JuliusOrtstadt/Maze_Game/README.md

# Maze_Game

Projet Arduino: Maze Game

Bienvenue sur le GitHub de mon projet arduino Maze_Game!
