JuliusOrtstadt/Maze_Game/Pièces/README.md

# Pièces

Contient toutes les pièces imprimées en 3D et découpé à la découpeuse laser
