JuliusOrtstadt/Maze_Game/Documentation/Presentation/README.md

# Présentation du projet

Contient:
- Le rapport final.
- La vidéo de présentation.
- La présentation PowerPoint en pdf.
