JuliusOrtstadt/Maze_Game/Documentation/Rapports/Rapport_Séance_8-Julius_ORTSTADT.md

# Rapport Séance 8 - 02.03.2023

## Avant la séance d’aujourd’hui, j‘ai : 
-	Créé une version préliminaire de test du code final. Ce dernier test une majeure partie des fonctionnalités notamment le contrôle des servo-moteurs avec le joystick, la navigation à travers le menu et l’affichage des différentes étapes à travers l’écran LCD et les deux LED.
-	Peint le labyrinthe en noir.\
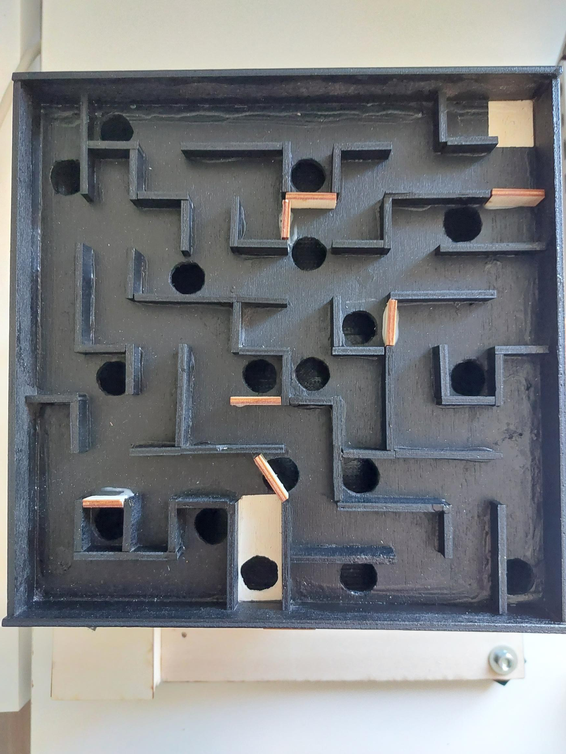
[picture p1: Documentation/Pictures/Seance_8/Labyrinth.jpg]
Labyrinthe


-	Modélisé les dernières pièces sur OnShape.\
  Le système de détection de la bille\
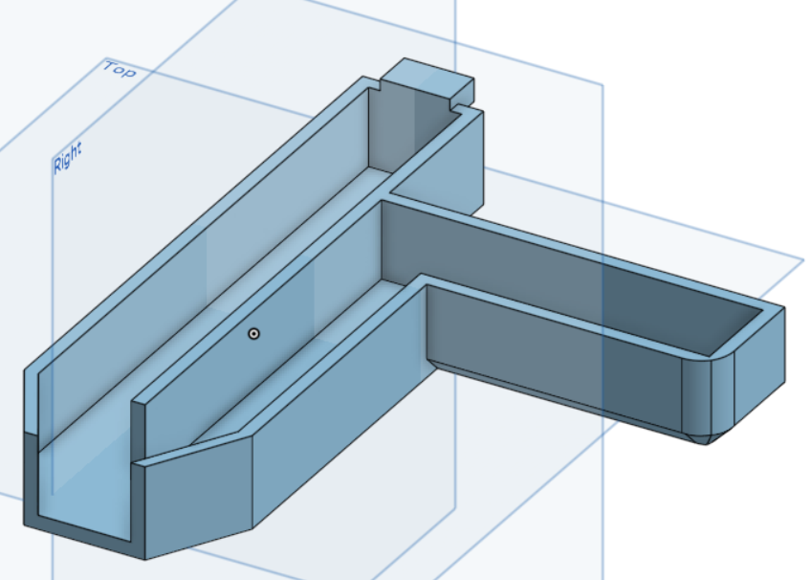
[picture p2: Documentation/Pictures/Seance_8/Collection.png]
Pièce 1
\
  La fixation pour le servo de la porte\
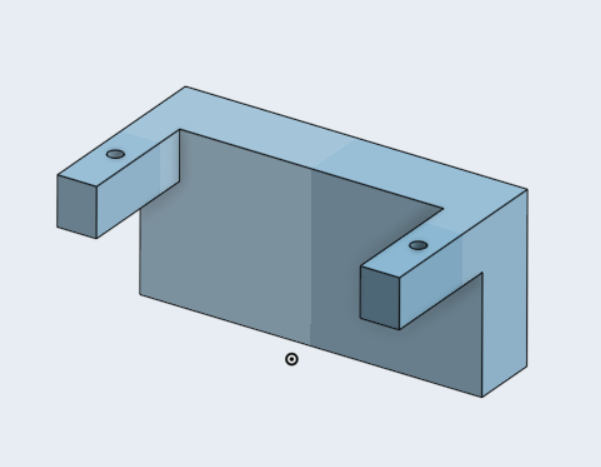
[picture p3: Documentation/Pictures/Seance_8/Fixation_Servo_Door.png]
Pièce 2
\
  La fixation pour la porte\
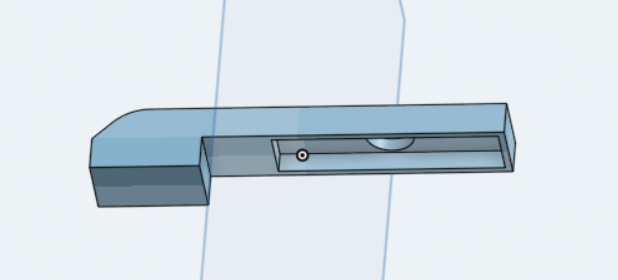
[picture p4: Documentation/Pictures/Seance_8/Door_Part.png]
Pièce 3


-	Commencé la soudure des composants.
-	Fixé certains composants notamment la carte Arduino et les planches à essai.\
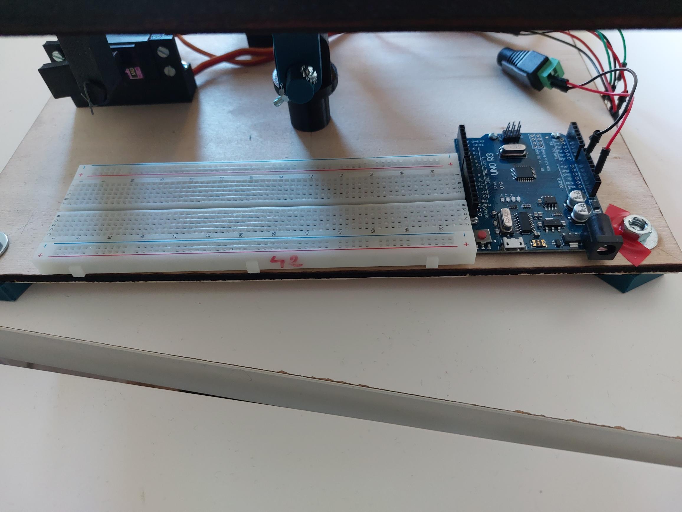
[picture p5: Documentation/Pictures/Seance_8/Fixation.jpg]
Fixage


## Lors de cette séance, j’ai :
-	Réglé un problème lié à l’alimentation.
-	Continuer le développement du code. Il ne manque que quelques réglages et de faire le calibrage des servo-moteurs et du joystick.\
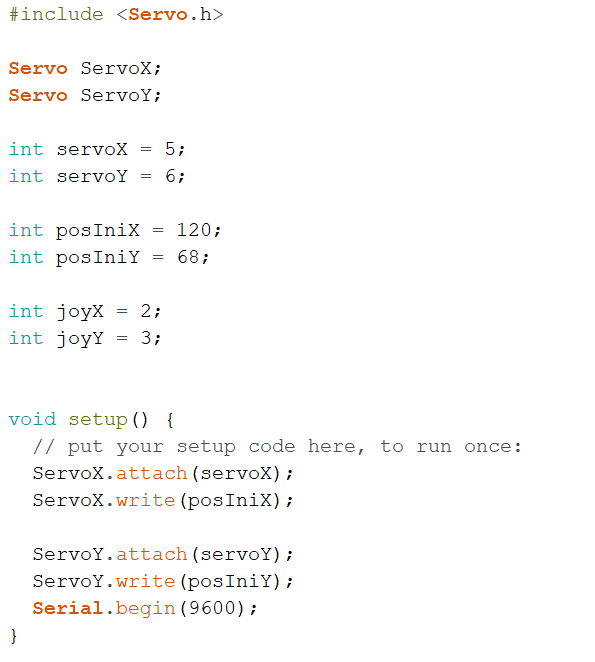
[picture p6: Documentation/Pictures/Seance_8/Code_p1.png]
Code 1

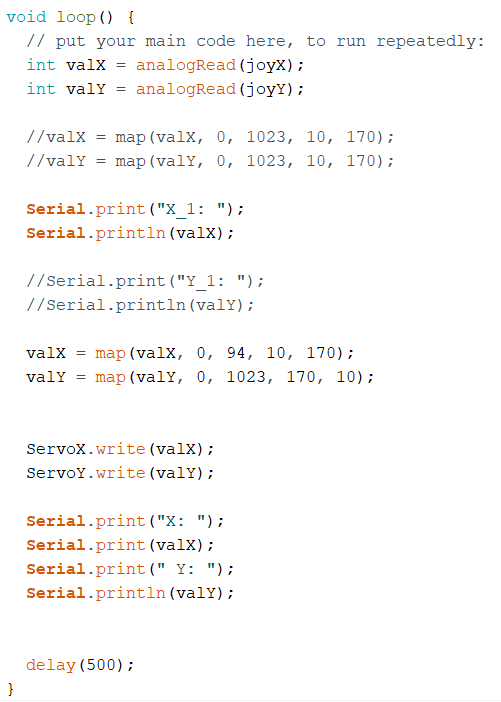
[picture p7: Documentation/Pictures/Seance_8/Code_p2.png]
Code 2


-	Imprimer les dernières pièces du projet et commencer leur intégration dans le projet.
-	Continué les soudures notamment des LED et du bouton.\
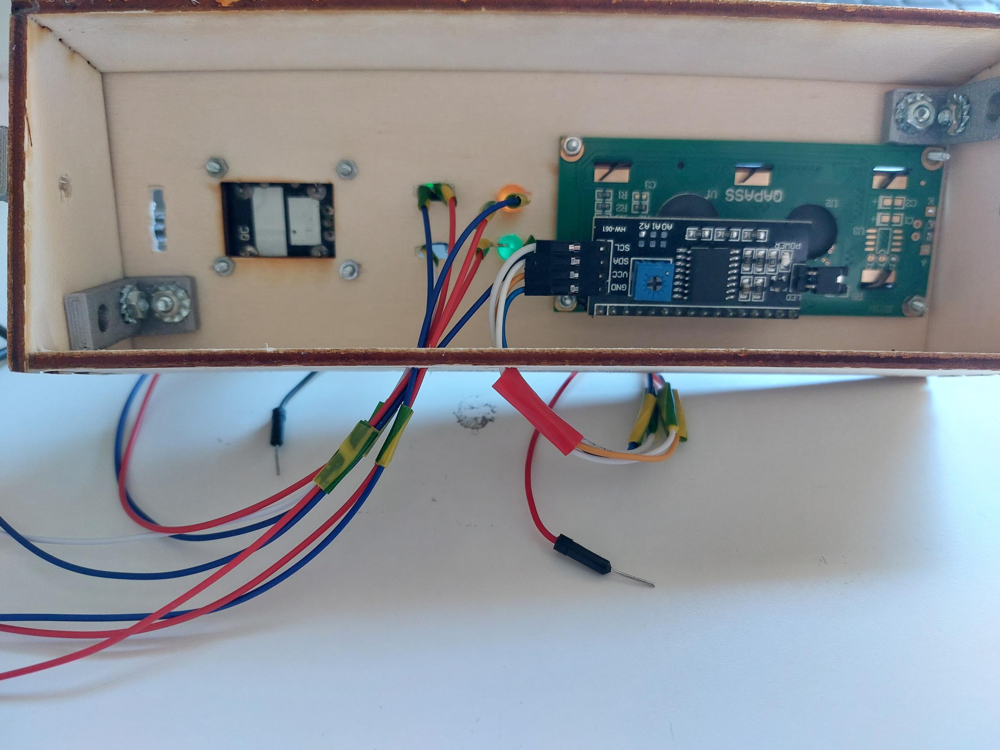
[picture p8: Documentation/Pictures/Seance_8/Welds.jpg]
Soudures

-	Presque fini l’assemblage complet. Il ne manque que le système de libération qui est prêt à être assemblé.\
  Fixation du servo pour la porte\
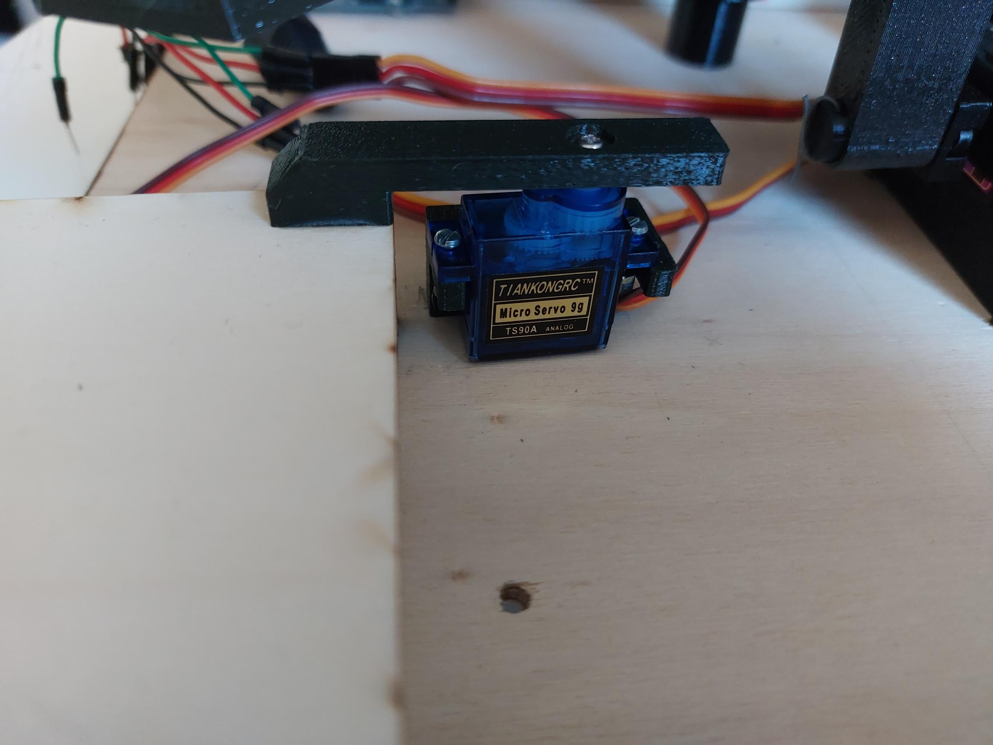
[picture p9: Documentation/Pictures/Seance_8/Servo_Door.jpg]
Servo Porte
