JuliusOrtstadt/Maze_Game/Documentation/Rapports/Rapport_Séance_7-Julius_ORTSTADT.md

# Rapport séance 7 - 16.02.2023

Avant cette séance, j’ai :
-	Fini l’assemblage du labyrinthe 
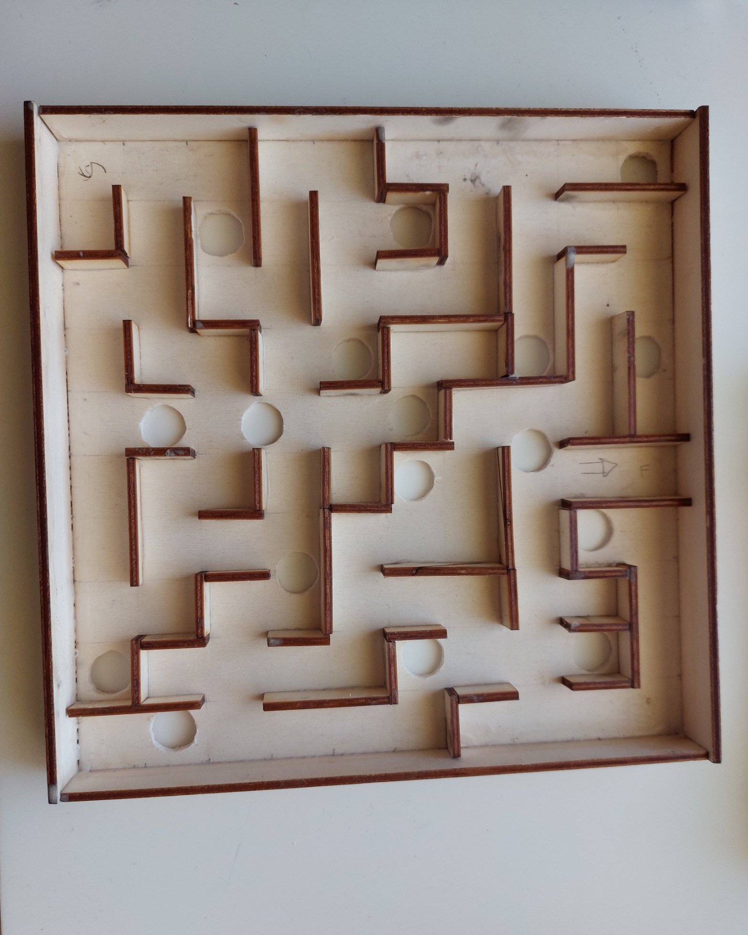
[picture p10: Documentation/Pictures/Seance_7/Labyrinth.jpg]
Assemblage labyrinthe fini

-	Commencer l’assemblage du bloc de contrôle

-	Commencé le code principal

Lors de cette séance, j‘ai :
-	Fini l’assemblage du bloc de contrôle 
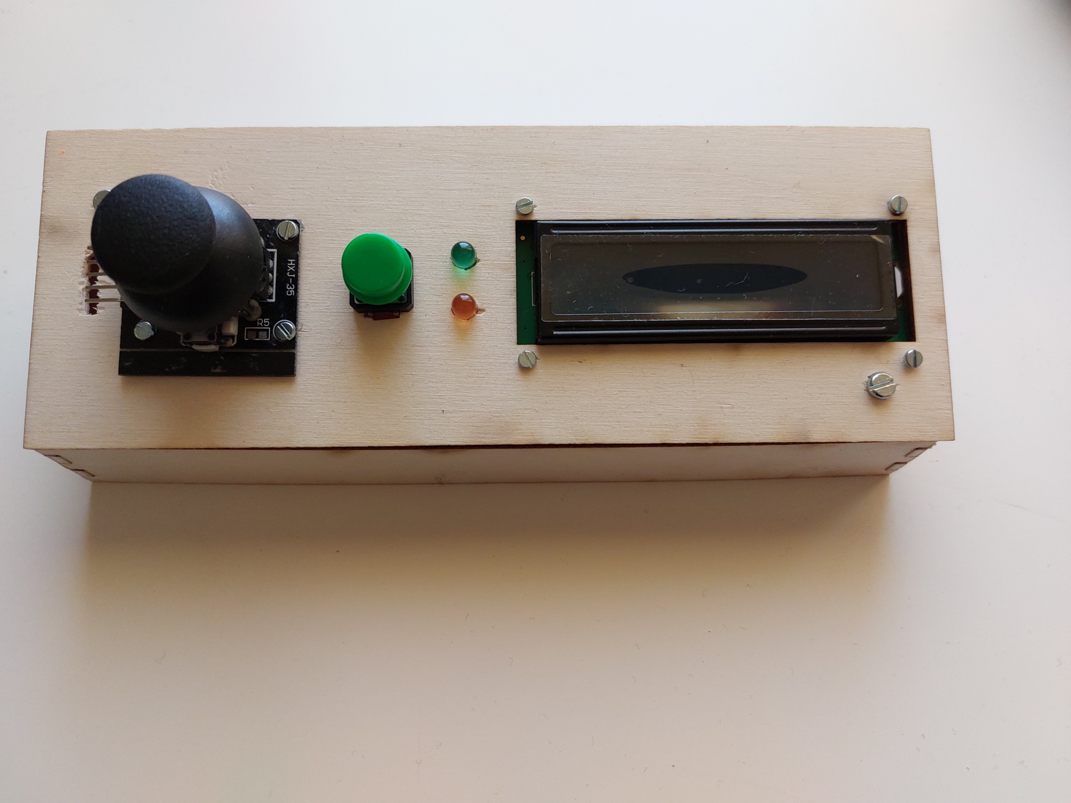
[picture p11: Documentation/Pictures/Seance_7/Menu_Block.jpg]
Bloc de contrôle


-	Fait l’assemblage du mécanisme pour le mouvement de plaque
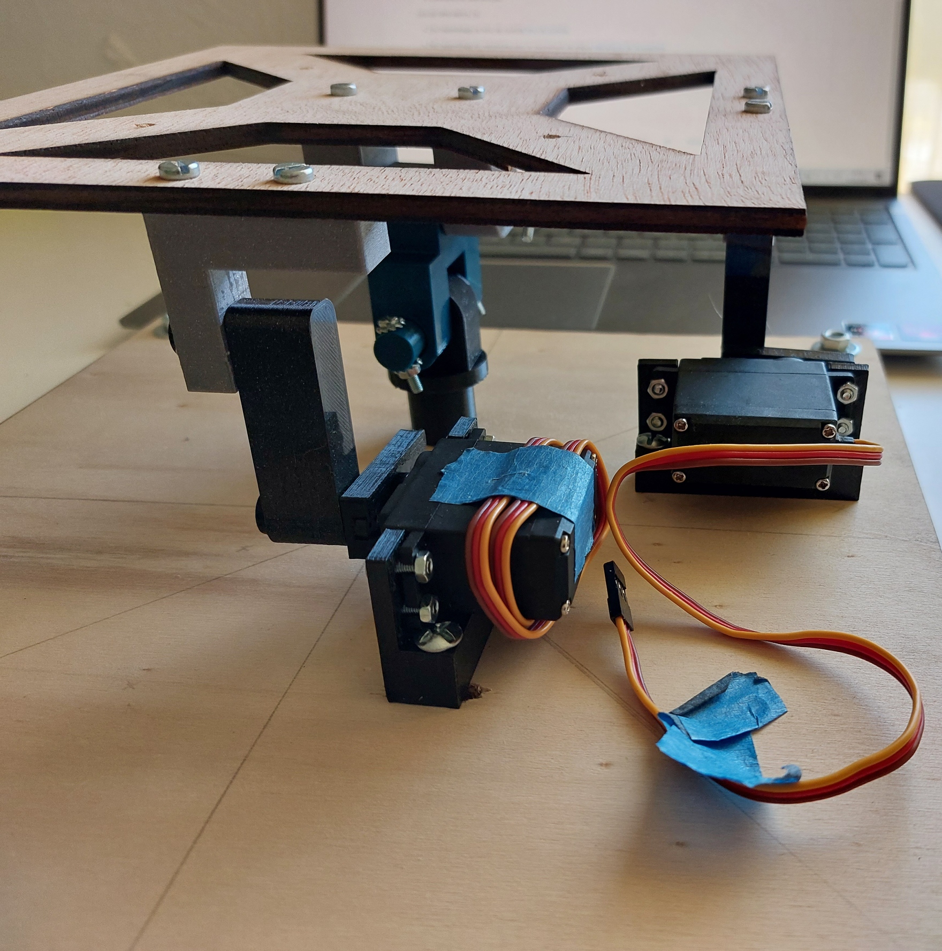
[picture p12: Documentation/Pictures/Seance_7/Mouvement_Control.jpg]
Mécanisme de mouvement


-	Modélisé et lancé l’impression des pièces permettant la recollection de la bille
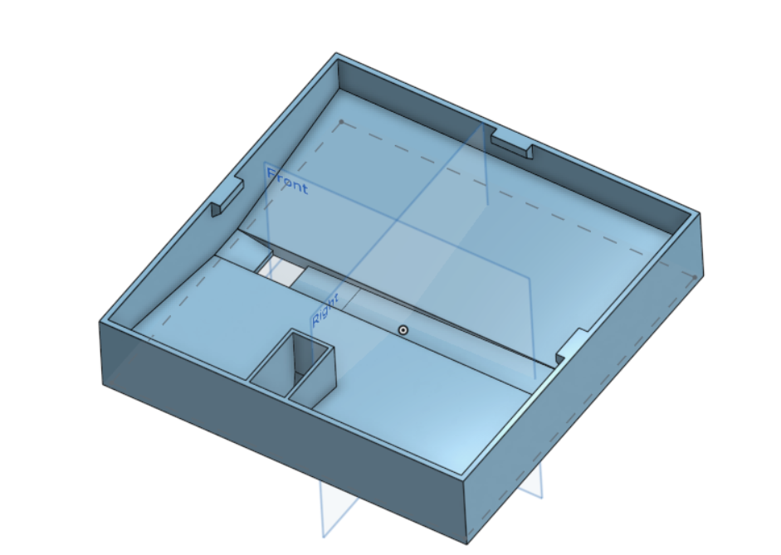
[picture p13: Documentation/Pictures/Seance_7/Collection_System.PNG]
Impression des pièces pour la recollection
