JuliusOrtstadt/Maze_Game/Documentation/Rapports/Rapport_Séance_6-Julius_ORTSTADT.md

# Rapport séance 6 - 09.02.2023

**Travail avant la séance :**\
Avant cette séance j’ai notamment préparé certaines pièces pour impression qui vont assurer le mouvement du plateau de jeu ainsi que permettre au joueur de contrôler ce mouvement.

-	Modélisation de pièces pour les servos moteurs afin d’assurer la transmission du mouvement au plateau de jeu.\
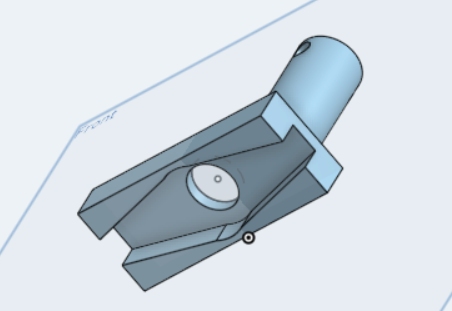
[picture p14: Documentation/Pictures/Seance_6/Servo_Adapter.PNG]
Pièces servos


-	Modélisation du bloc « menu » où une grande partie des composants sera installée.

**Travail lors de la séance :**\
Lors de cette séance, j’ai commencé l’assemblage du projet et j’ai aussi fait quelques changements sur des pièces dont tout ne fonctionner pas exactement comme prévu.

-	Fixation des supports sur la planche de contrôle avec des vis.\
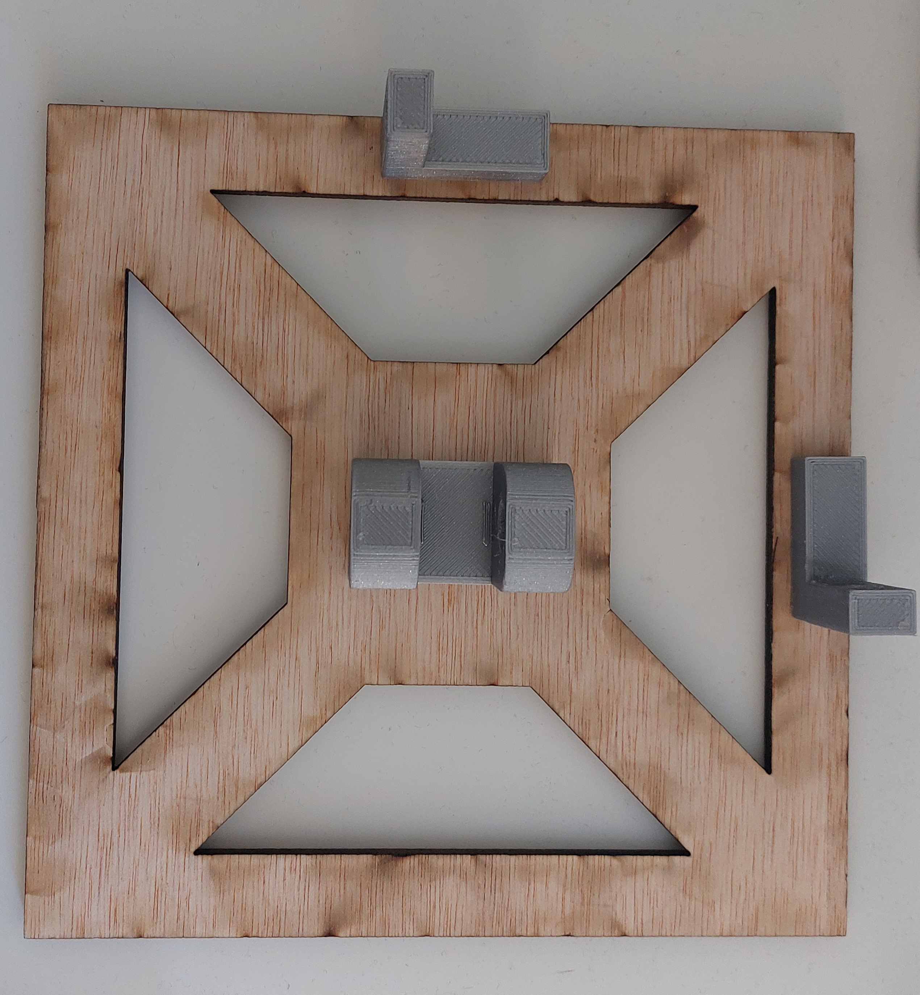
[picture p15: Documentation/Pictures/Seance_6/Support_Assembly.jpg]
Fixation des supports


-	Perçage des trous du labyrinthe et début du collage des pièces du labyrinthe.\
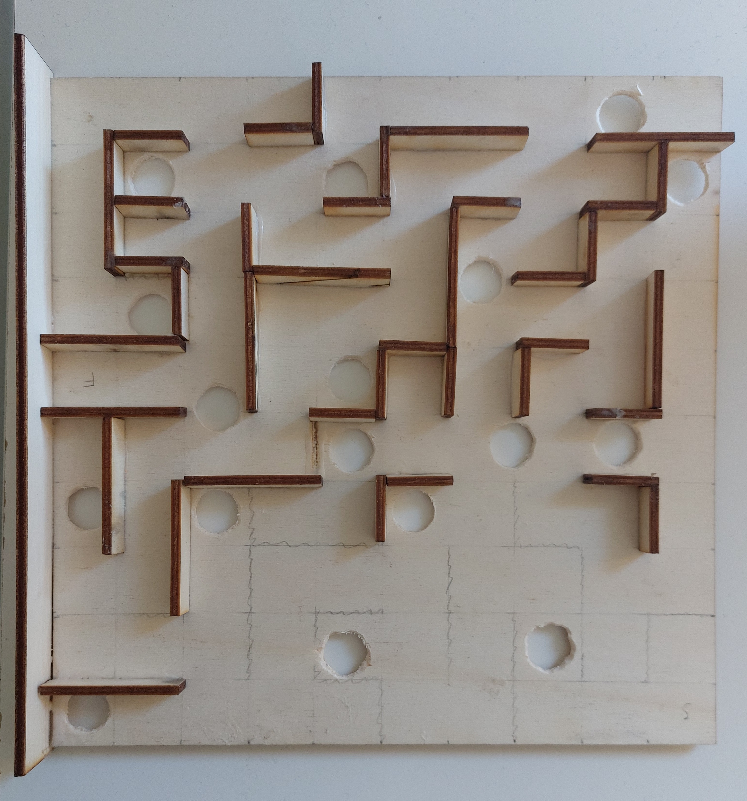
[picture p16: Documentation/Pictures/Seance_6/Labyrinth_Assembly.jpg]
Début de l'assemblage du labyrinthe


-	Amélioration du bloc "menu" afin que l’assemblage soit plus facile.\
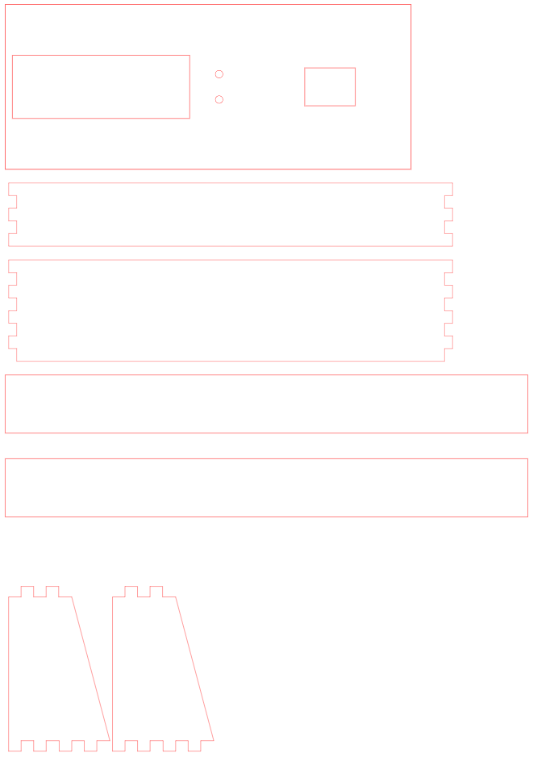
[picture p17: Documentation/Pictures/Seance_6/Menu_Block_Pieces.PNG]
Modification du bloc "menu"
