JuliusOrtstadt/Maze_Game/Documentation/Rapports/Rapport_Séance_5-Julius_ORTSTADT.md

# Rapport Séance 5 - 02.02.2023

Avant cette séance, j’ai dessiné les pièces du labyrinthe pour la découpe laser. 
J’ai ensuite découpé ces pièces et commencer l’assemblage.
- Murs pour le labyrinthe\
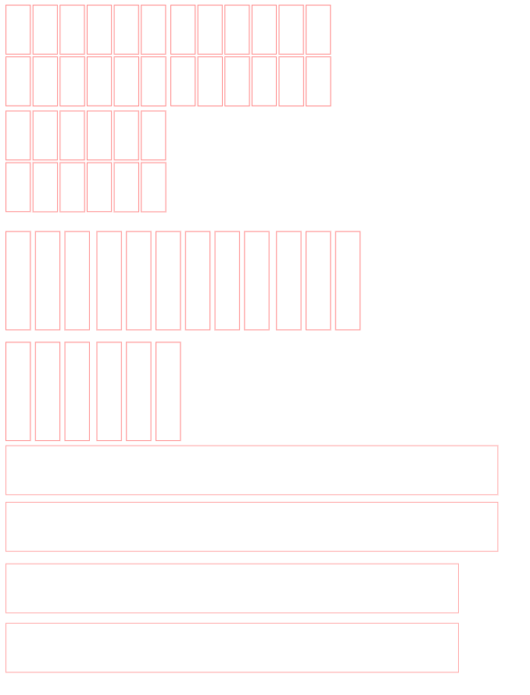
[picture p18: Documentation/Pictures/Seance_5/Labyrinth_Wall.PNG]
Murs pour le labyrinthe


- Plaque de base pour le labyrinthe\
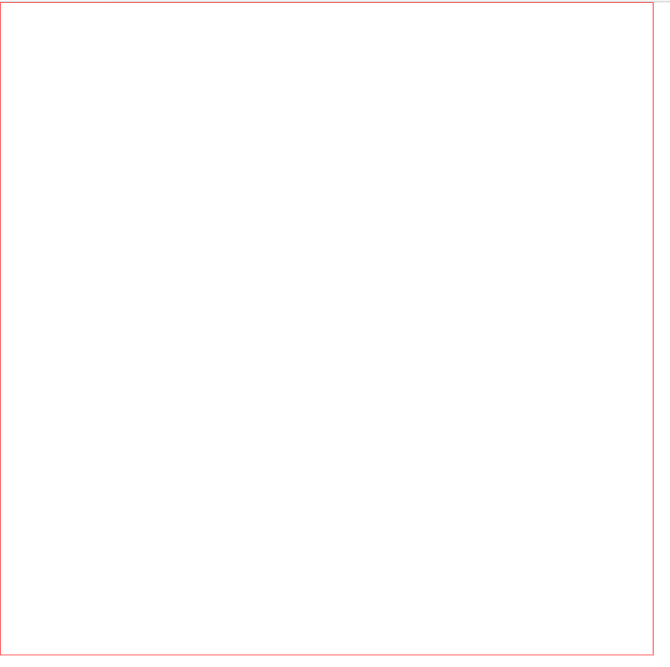
[picture p19: Documentation/Pictures/Seance_5/Labyrinth_Plate.PNG]
Plaque de base du labyrithne


- Plaque qui sera bougée par les servos moteurs\
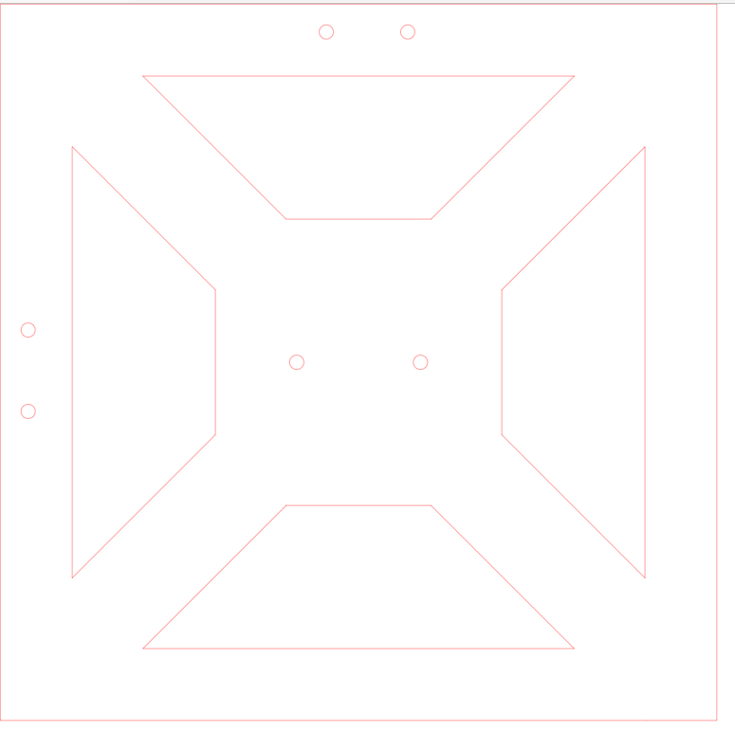
[picture p20: Documentation/Pictures/Seance_5/Main_Plate.PNG]
Plaque de base


Ensuite, lors de cette séance, j’ai commencé à coder les fonctionnalités du joystick.
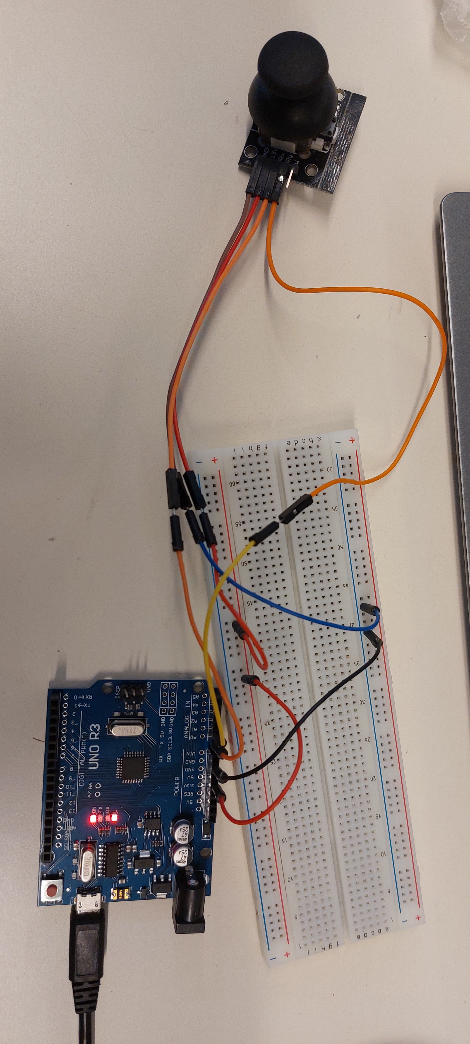
[picture p21: Documentation/Pictures/Seance_5/Montage_joystick.jpg]
Image du montage


De plus, j’ai réussi à régler le problème de l’écran LCD.\ 
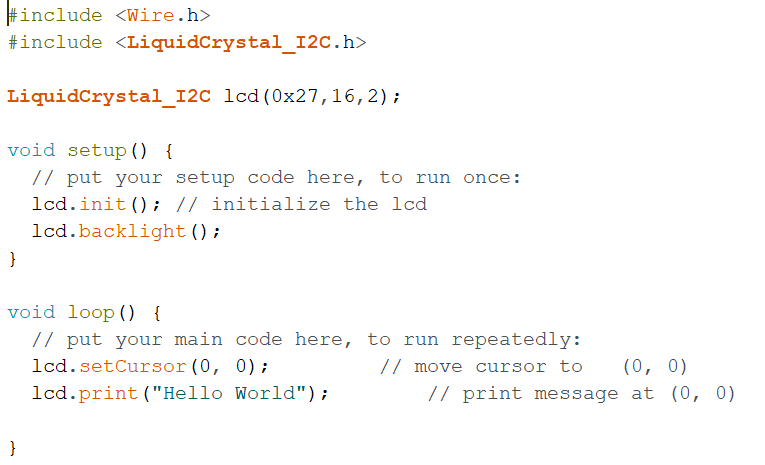
[picture p22: Documentation/Pictures/Seance_5/Code_LCD_Test.PNG]
Code écran LCD


J’ai aussi tester un autre système de détection de la bille avec les capteurs que l’on avait utiliser pour les voitures suiveurs de ligne. Ce système permettrait de plus compacter la construction et de simplifier l’assemblage.\
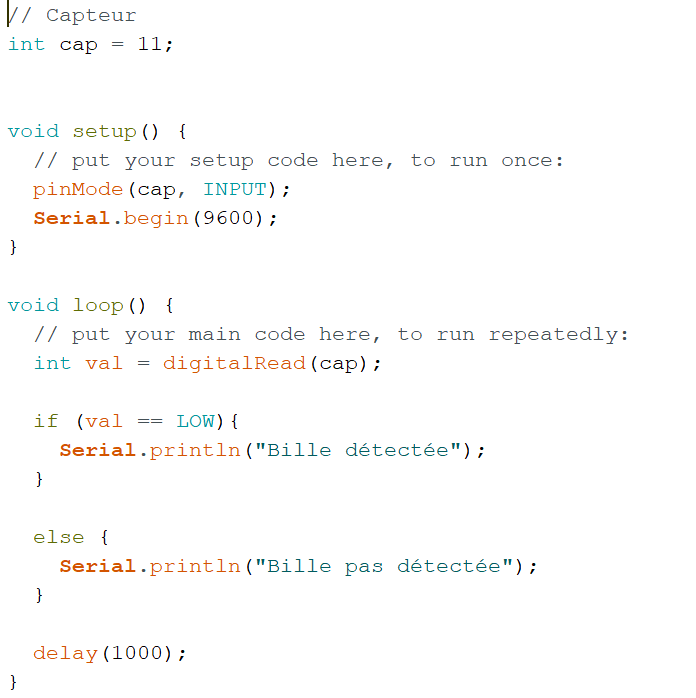
[picture p23: Documentation/Pictures/Seance_5/Code_Detection_Test.PNG]
Code système de détection
