JuliusOrtstadt/Maze_Game/Documentation/Rapports/Rapport_Séance_4-Julius_ORTSTADT.md

# Rapport de la séance 4 - 16.01.2023

Lors de cette séance j‘ai avancer les montages électroniques. 
-	J'ai fait des test avec l’écran LCD avec I2C. Cependant certains problèmes sont survenus notamment que le réglage du contraste était impossible ce qui ne permettait pas d'apercevoir le texte.\
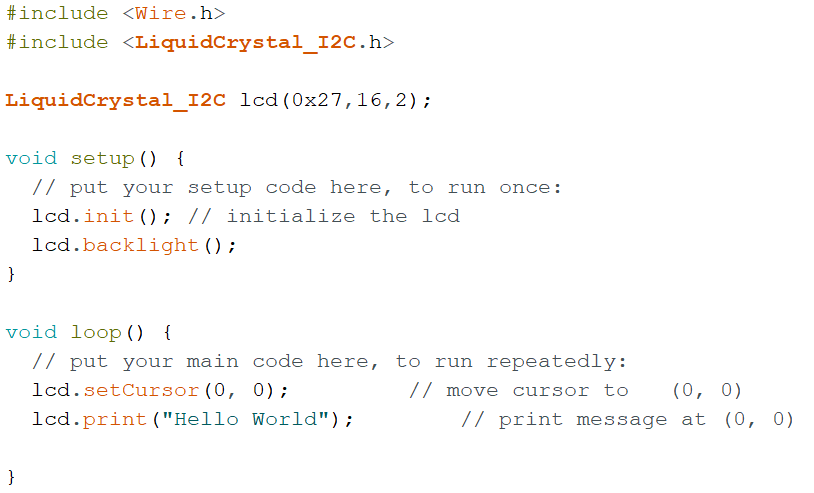
[picture p24: Documentation/Pictures/Seance_4/Code_LCD.PNG]
Code de test


J’ai revu certaines versions des pièces. Par exemple la fixation du servo n’était pas assez large.\
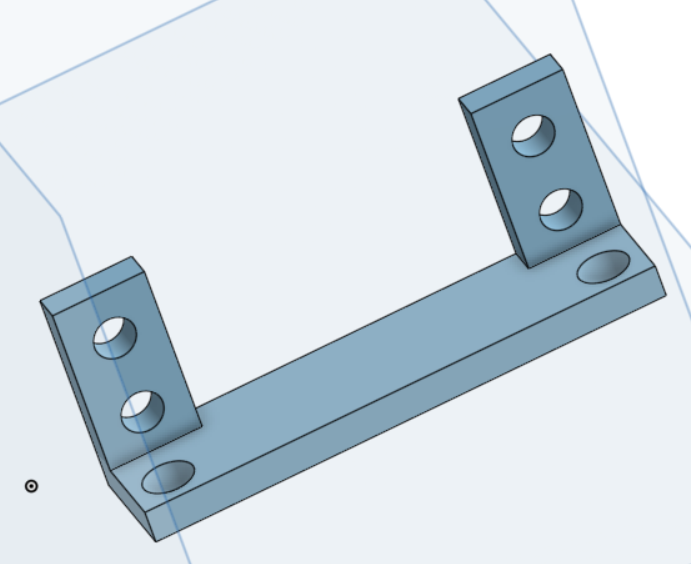
[picture p25: Documentation/Pictures/Seance_4/Fixation_Servo.PNG]
Fixation servo


Et pour la plaque sur laquelle sera fixé le labyrinthe, j’ai décomposé l’assemblage en plusieurs parties, notamment, les angles ainsi que la fixation pour le joint vont être fait séparément par impression 3D puis fixé sur la planche avec des vis. Ces pièces ont été lancé en impression 3D. La planche elle-même sera faites en bois par découpe laser.\
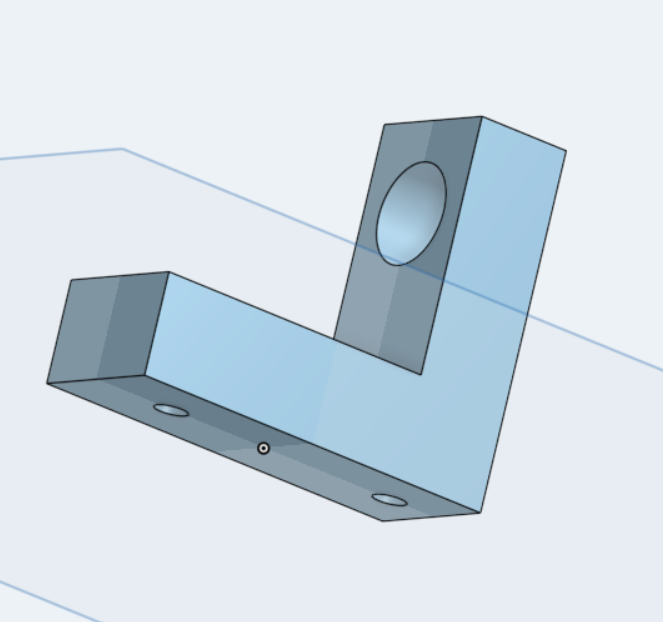
[picture p26: Documentation/Pictures/Seance_4/Angle.PNG]
Angles


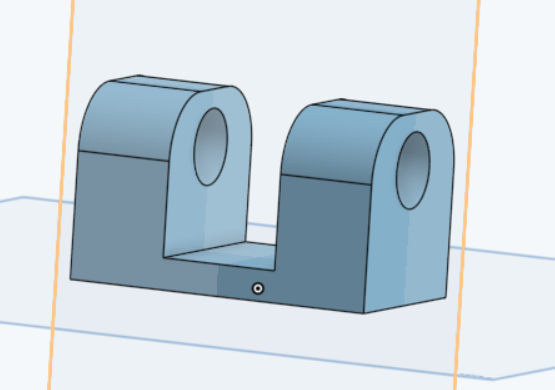
[picture p27: Documentation/Pictures/Seance_4/Fixation_Game_Plate.PNG]
Fixation joint


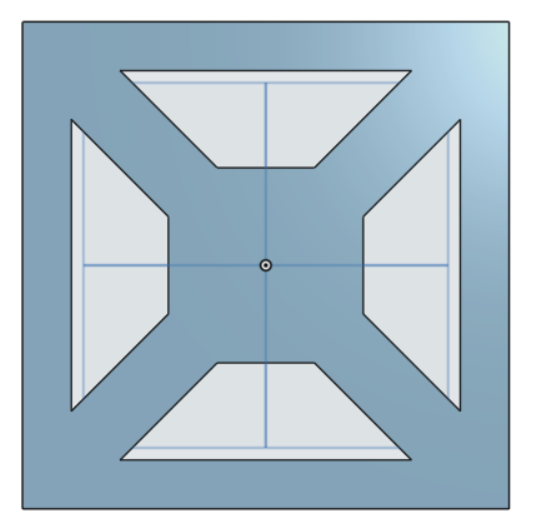
[picture p28: Documentation/Pictures/Seance_4/Main_Plate_2.PNG]
Planche principale


J’ai aussi commencer à modéliser le « bloc de contrôle » donc le bloc sur lequel seront fixé tout les boutons, l’écran, le joystick et les LED.
Finalement, j'ai aussi présenter l'avancement de mon projet lors de la présentation de mi-parcours.
