JuliusOrtstadt/Maze_Game/Documentation/Rapports/Rapport_Séance_3-Julius_ORTSTADT.md

# Rapport Séance 3 - 09.01.2023

Avant cette séance, j'ai revu certaines pièces modélisées la dernière fois et j'ai fait l'assemblage sur OnShape pour voir le rendu de la structure principale.
- Modification des certaines pièces de l'assemblage:
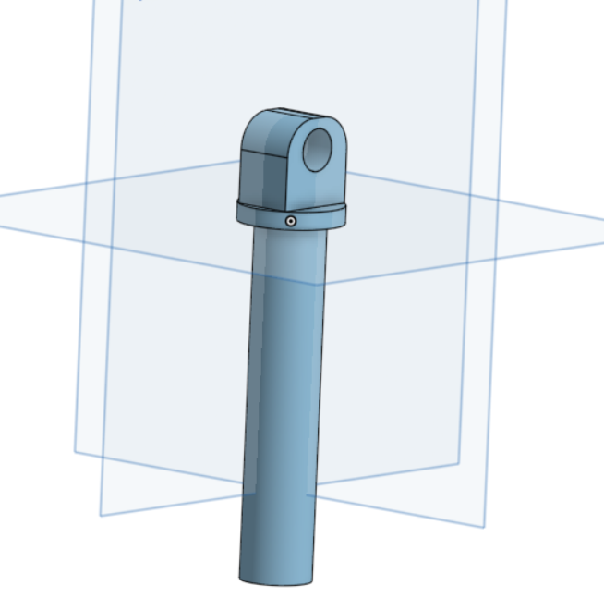
[picture p29: Documentation/Pictures/Seance_3/Main_Mouvement_Joint.PNG]

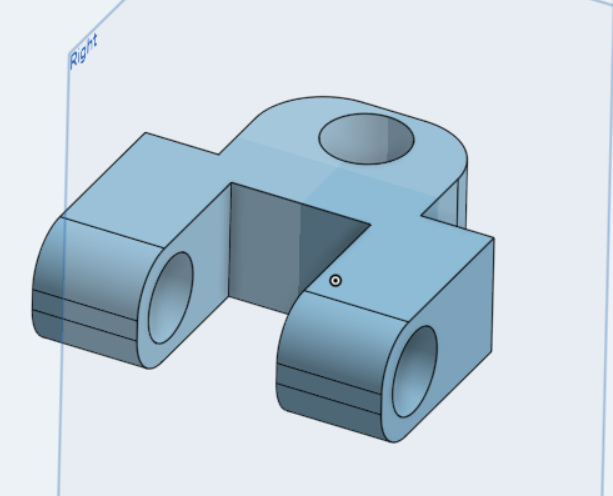
[picture p30: Documentation/Pictures/Seance_3/Main_Mouvement_Joint_2.PNG]


- Image de l'assemblage de la structure de base:
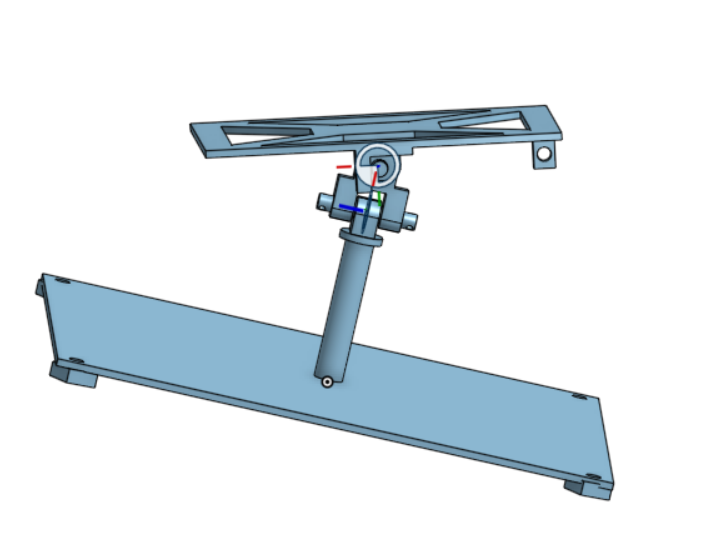
[picture p31: Documentation/Pictures/Seance_3/Assembly_1.PNG]

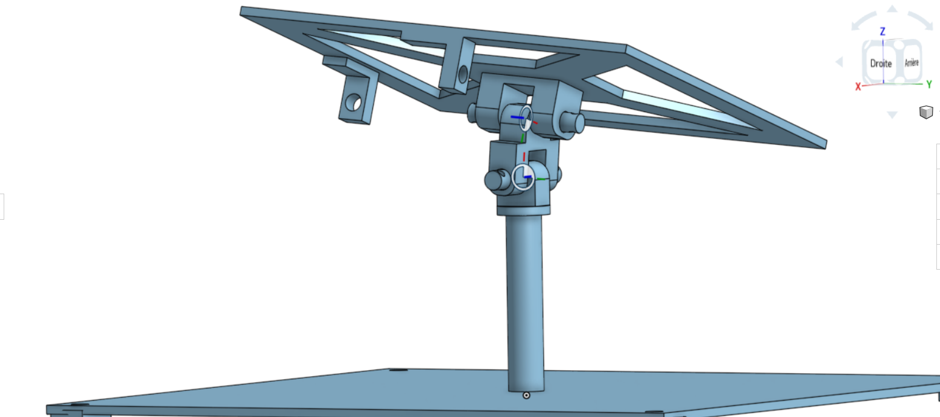
[picture p32: Documentation/Pictures/Seance_3/Assembly_2.PNG]


Lors de la séance 3, j'ai effectué différents tests de code et de montages:
- Test du servo qui active la porte qui permet par la suite de libérer la bille. 
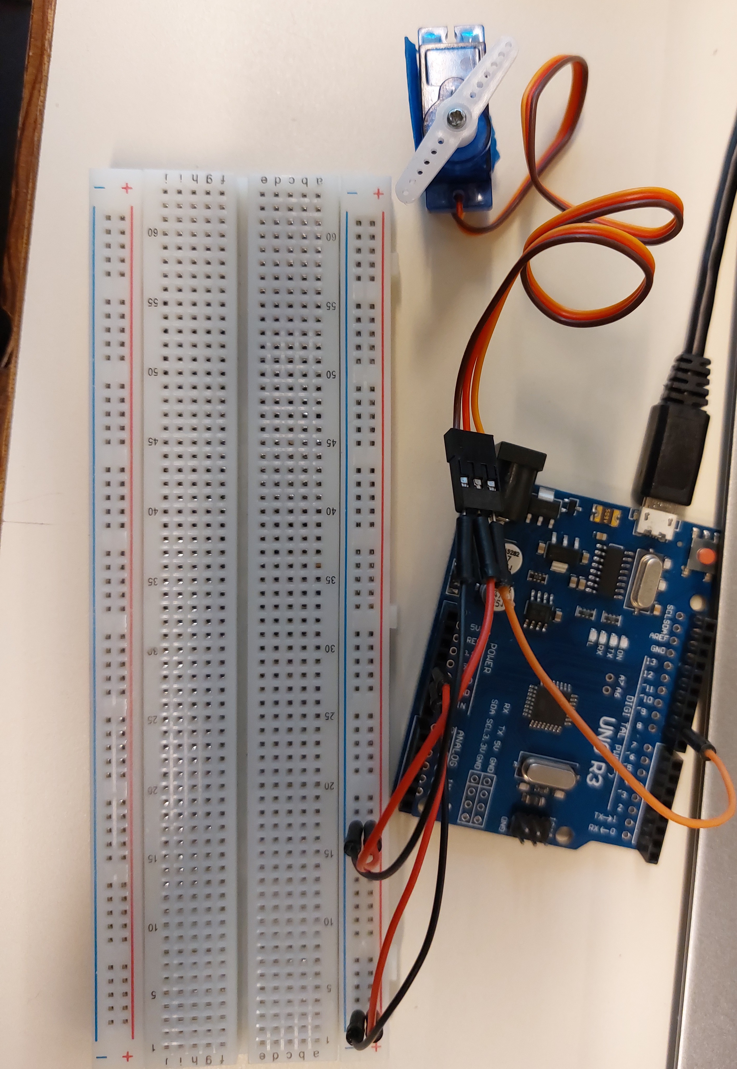
[picture p33: Documentation/Pictures/Seance_3/Montage_servo_porte.jpg]
Image du montage


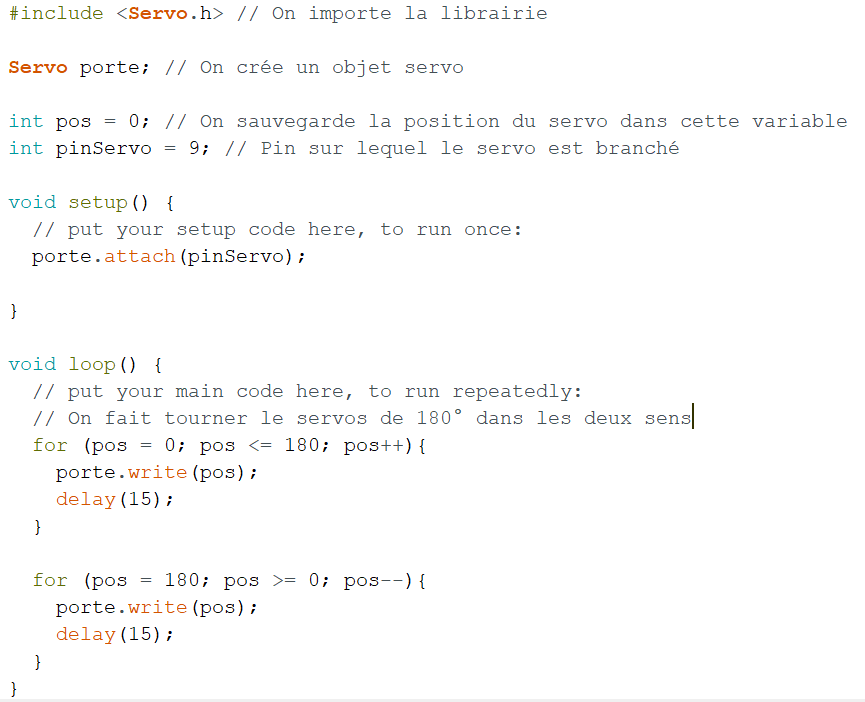
[picture p34: Documentation/Pictures/Seance_3/Code_Door_Test.PNG]
Code


- Test des boutons qui détectent si la bille est tombé et si le joueur a gagné.
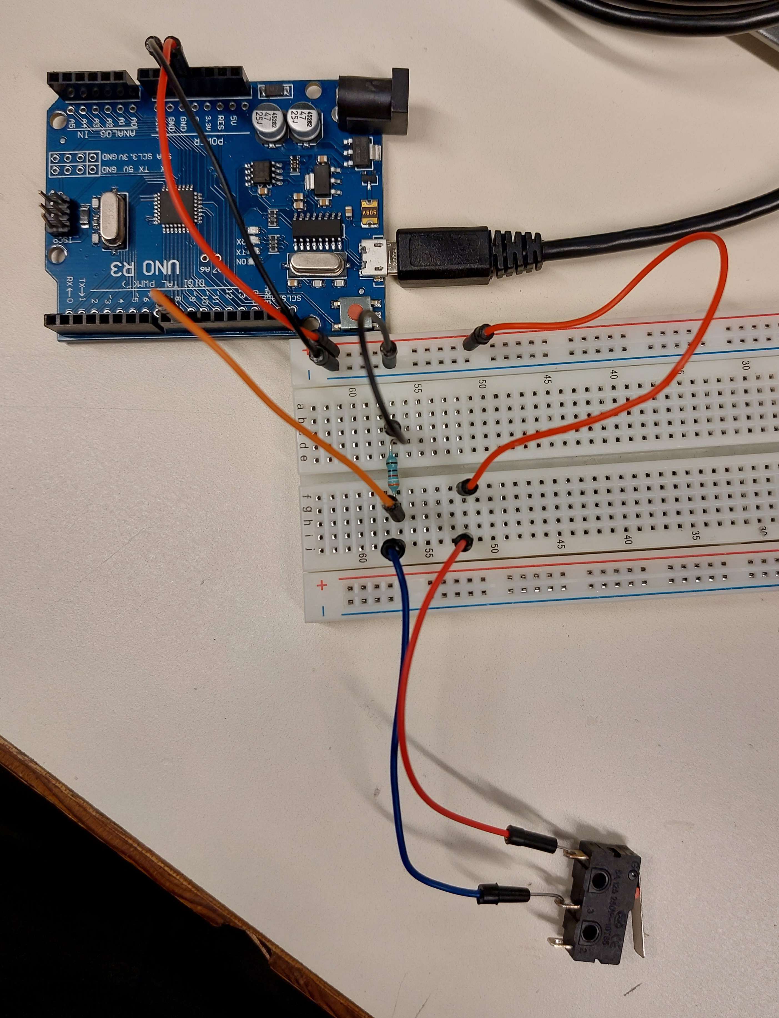
[picture p35: Documentation/Pictures/Seance_3/Montage_bouton_simple.jpg]
Image du montage


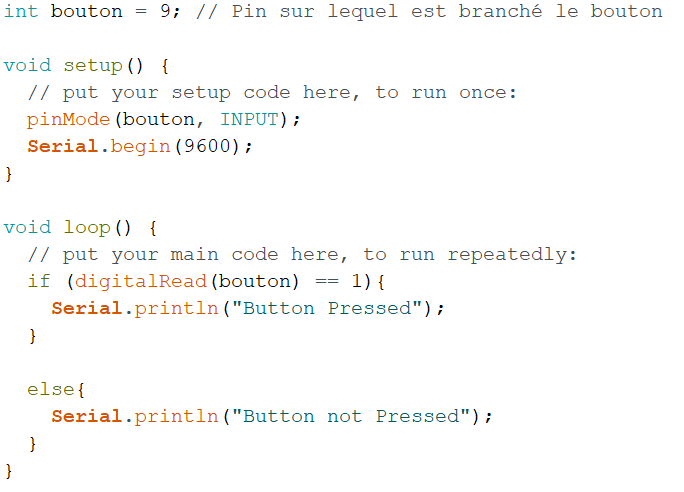
[picture p36: Documentation/Pictures/Seance_3/Code_Button_Test.PNG]
Code


De plus, la plaque principale a été découpé en 29x29cm. 
Les pièces du joints, ainsi que les barres de fixation tout comme les pieds pour la plaque principale ont été lancé en impression 3D.
