JuliusOrtstadt/Maze_Game/Documentation/Rapports/Rapport_Séance_2-Julius_ORTSTADT.md

# Rapport Séance 2 - 19.12.2022

Lors de cette séance j'ai modélisé une grande parties des pièces nécessaires pour le projet. Certaines seront imprimées en 3D tandis que d'autres comme la plaque principale sur laquelle tout sera fixé, sera faites en bois.

Les différentes pièces modélisées sont:
- La planche principale sur laquelle tout sera fixé.
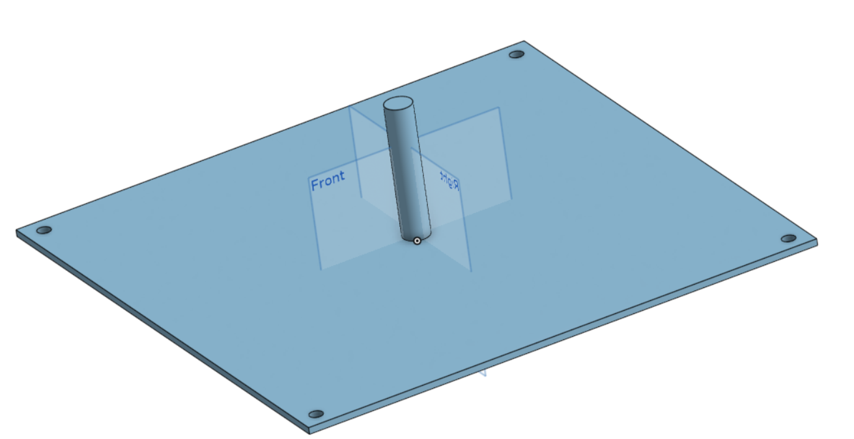
[picture p37: Documentation/Pictures/Seance_2/base_plate.PNG]
Planche principale

- Les pieds pour cette planche afin de pouvoir la poser et faire le niveau. Ce dernier sera fait avec une vis insérée dans ce pieds.

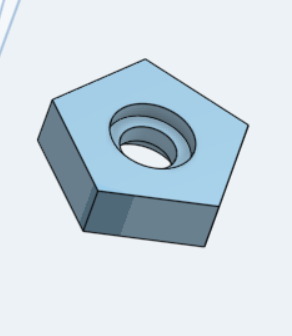
[picture p38: Documentation/Pictures/Seance_2/foot_base_plate.PNG]
Pieds de la planche principale

- Le système de maintient pour les servos moteurs qui assurent le mouvement de la planche de jeu.
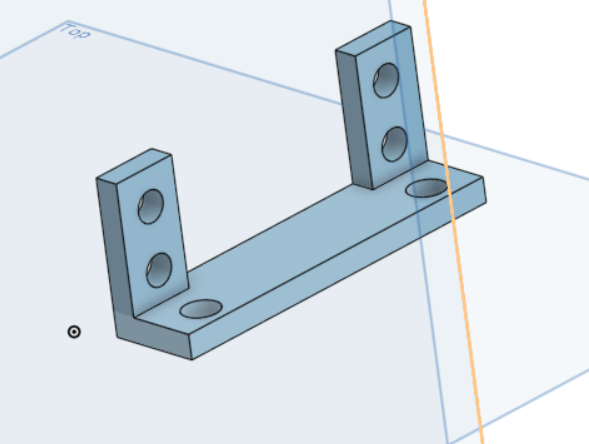
[picture p39: Documentation/Pictures/Seance_2/servo_hold.PNG]
Système de maintient pour les servos moteurs

- Les différentes parties du joint pour permettre le mouvement de la planche de jeu.
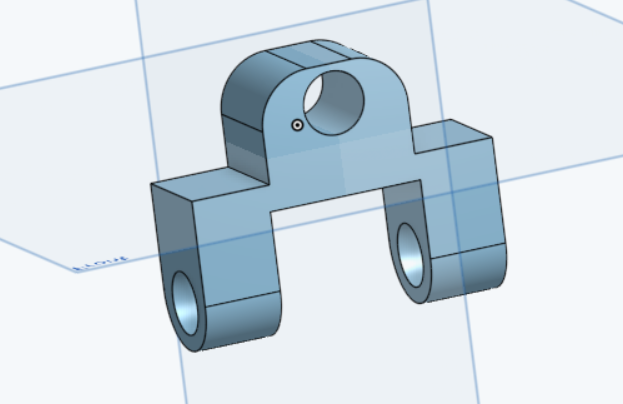
[picture p40: Documentation/Pictures/Seance_2/joint_1.PNG]
Joint partie 1

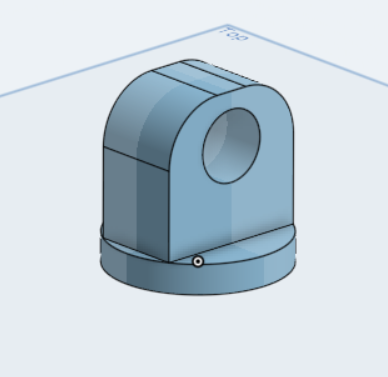
[picture p41: Documentation/Pictures/Seance_2/joint_2.PNG]
Joint partie 2

- La tige permettant d'assembler et de tenir en place les différentes parties du joint. Un fil de fer, par exemple, sera placer dans les trous au bout de la tige afin que celle-ci ne tombe pas du joint.
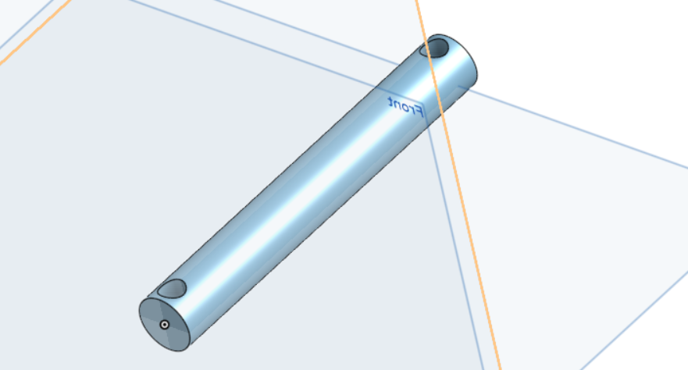
[picture p42: Documentation/Pictures/Seance_2/rod.PNG]
Tige

- La plaque sur laquelle sera fixée le labyrinthe.
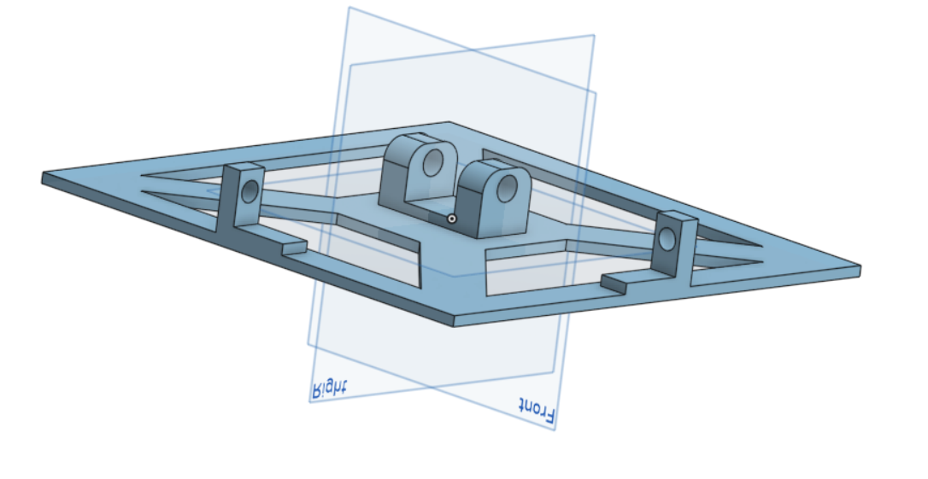
[picture p43: Documentation/Pictures/Seance_2/game_plate.PNG]
Plaque de fixation du labyrinthe


Finalement, j'ai aussi recherché des alternatives pour le système de détection de la bille, c'est-à-dire pour savoir si la bille est tombée donc si le joueur a perdu ou gagné en fonction de l'endroit. Une de ces alternivatives serait d'utiliser un bouton sur lequel la bille tomberait mais il faut encore vérifier si le poids de la bille utilisée sera suffisant pour l'activer.
