JuliusOrtstadt/Maze_Game/Documentation/Liste_du_materiel.md

# Liste du matériel

| Matériel | Nombre |
| --- | --- |
| Arduino | 1 |
| Planche à essai | 1 |
| Joystick | 1 |
| Écran LCD | 1 |
| Bouton | 1 |
| LED Verte | 1 |
| LED Orange | 1 |
| Moteur Servo MG996R | 2 |
| Moteur Servo sg90 | 1 |
| Capteurs infra-rouge | 2 |
| Bille | 1 |
| Impression de pièces en 3D | x |
| Bois en découpage laser | x |
| Câbles | x |
