JuliusOrtstadt/Maze_Game/Documentation/Cahier_des_charges.md

# Cahier des charges - Maze_Game

**NOM DU PROJET :** \
Maze_Game

**DESCRIPTION DU PROJET :**\
Maze_Game est un jeu de labyrinthe dont le but est de naviguer une bille du point de départ au point final sans tomber dans les trous présents sur la planche de jeu.

Le contrôle du jeu est assuré par un joystick. Ce dernier règle l'angle des deux servos-moteur afin de gérer l'inclinaison de la planche de jeu.
De plus, un écran LCD affichera le temps écoulé depuis le départ afin que le joueur puisse connaître son score. Cet écran affichera aussi les différents statuts de la partie comme par exemple si le joueur a perdu i.e. la bille est tombée dans un trou, ou encore si le jeu commence etc.
Des boutons permettront de contrôler le jeu avant le début de la partie. 
Des capteurs détectent si la balle arrive au point final ou si le joueur a perdu.
Une barrière activée par un servo moteur libère la bille pour que le joueur puisse la positionner après avoir démarrer la partie.
