JuliusOrtstadt/Maze_Game/Code/README.md

# Codes du projet

Contient code de test et code final
