JuliusOrtstadt/Maze_Game/Pièces/Récupération_Bille/README.md

# Pièces pour le système de récupération de la bille.
