JuliusOrtstadt/Maze_Game/Pièces/Porte/README.md

# Pièces pour construire le système de porte qui renferme la bille.
