JuliusOrtstadt/Maze_Game/Pièces/Plaque_Principale/README.md

# Plaque Principale

Contient les pièces pour la plaque principale.
