JuliusOrtstadt/Maze_Game/Pièces/Mouvement/README.md

# Mouvement

Contient les pièces pour assurer le mouvement du labyrinthe.
