JuliusOrtstadt/Maze_Game/Pièces/Menu/README.md

# Menu

Contient toutes les pièces pour le bloc "menu".
