JuliusOrtstadt/Maze_Game/Pièces/Labyrinthe/README.md

# Labyrinthe 

Contient les pièces pour le labyrinthe
