JuliusOrtstadt/Maze_Game/Documentation/Pictures/README.md

# Dossier contenant les images du projet
