JuliusOrtstadt/Maze_Game/Documentation/Rapports/Rapport_Séance_1-Julius_ORTSTADT.md

# Rapport de séance 1 : 12.12.2022

Lors de la séance 1, j'ai effectué différentes tâches dont la conception (esquisse) de pièces élémentaires pour faire fonctionner le projet, la liste du matériel nécessaire. 
De plus, j'ai aussi déterminé certaines mesures notamment celles pour la planche de jeu.

- Réalisation de la liste de matériel nécessaire pour le projet:\
J'ai besoins de différents composants pour mon projet afin de réaliser les différents mouvements, affichages etc.

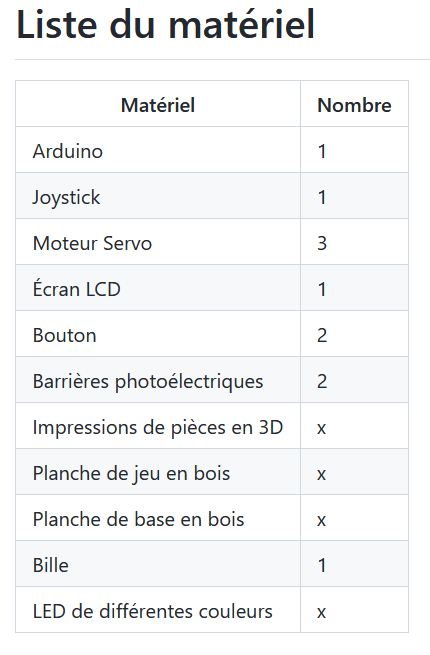
[picture p50: Documentation/Pictures/Seance_1/liste_du_materiel.PNG]
Image de la liste de matériel
\

- Réalisation de l'esquisse des différentes parties du projet:\
J'ai effectué différents dessins montrant les pièces élémentaires du projet dont les joints qui vont permettre l'articulation de la planche de jeu, le système de détection de la balle ainsi que le système pour récupérer cette dernière.\
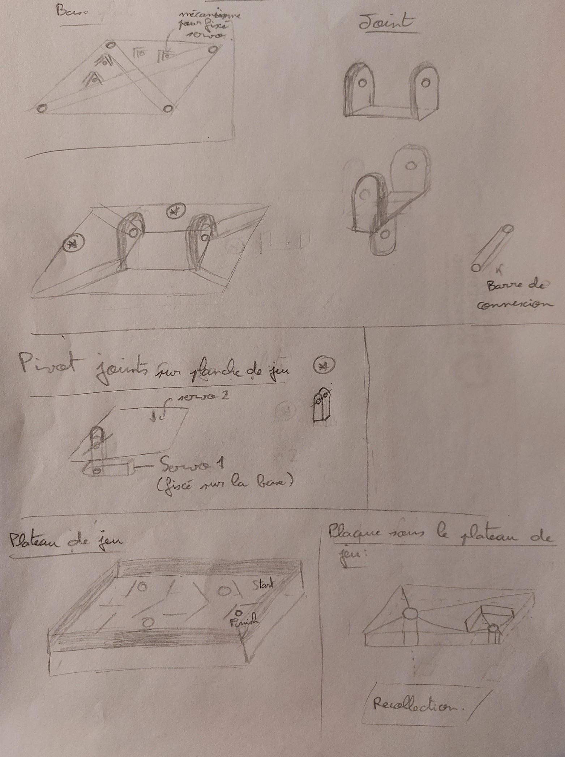
[picture p51: Documentation/Pictures/Seance_1/Esquisse_1.jpg]
Esquisse 1

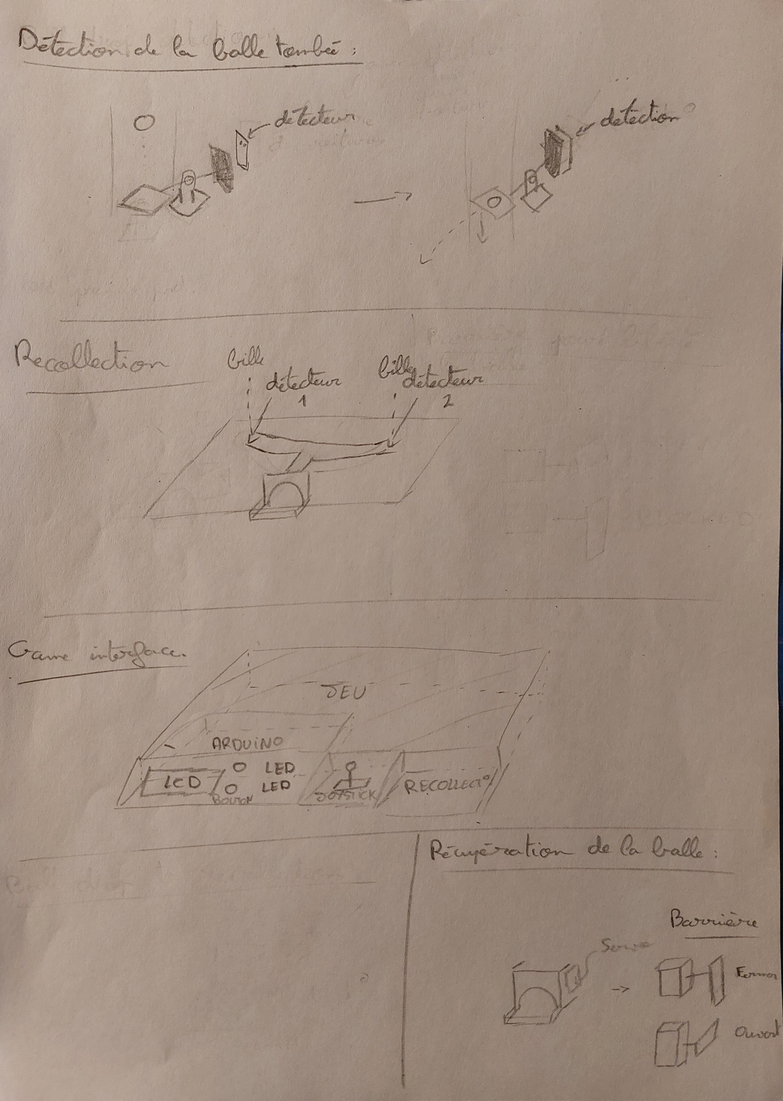
[picture p52: Documentation/Pictures/Seance_1/Esquisse_2.jpg]
Esquisse 2


- Détermination des mesures principales du projet:\
Après certaines expérimentations j'ai trouvé des mesures pour la planche de jeu. Je dois cependant encore adapter celle-ci avec la taille des servos-moteurs et d'autres éléments afin que tout fonctionne comme souhaité.
