JuliusOrtstadt/Maze_Game/Documentation/Planning.md

# Planning des séances

| Séance n° | Travail |
| --- | --- |
| Séance 1 – 12/12/2022 |<ul><li>Esquisse du projet<li>Liste du matériel<li>Détermination des dimensions du projet|
| Séance 2 – 19/12/2022 |<ul><li>Début de la conception de la planche de jeu (design)<li>Début de la modélisation des pièces|
| Séance 3 – 09/01/2023 |<ul><li>Schéma du montage électronique<li>Test de certaines fonctionnalités|
| Séance 4 – 16/01/2023 |<ul><li>Codage des fonctionnalités de base (contrôle de la planche)|
| Séance 5 – 02/02/2023 |<ul><li>Codage des fonctionnalités de détection de début de jeu|
| Séance 6 – 09/02/2023 |<ul><li>Production des pièces<li>Début de l’assemblage|
| Séance 7 – 16/02/2023 |<ul><li>Intégration code-jeu<li>Test des fonctionnalités|
| Séance 8 – 02/03/2023 |<ul><li>Finalisation du code<li>Finalisation de l’assemblage|
| Séance 9 – 09/03/2023 |<ul><li>Soutenance|
