JuliusOrtstadt/Maze_Game/Documentation/Pictures/Seance_8/Collection_ball.jpg

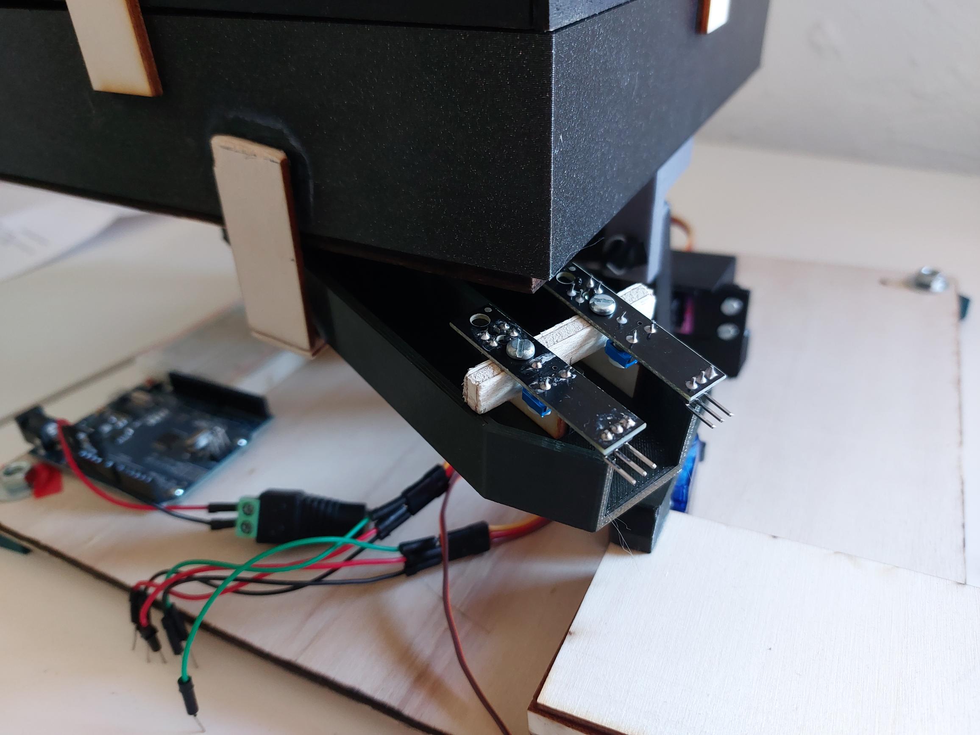
Documentation/Pictures/Seance_8/Collection_ball.jpg
