JuliusOrtstadt/Maze_Game/Pièces/Plaque_Principale/Foot_Main.stl

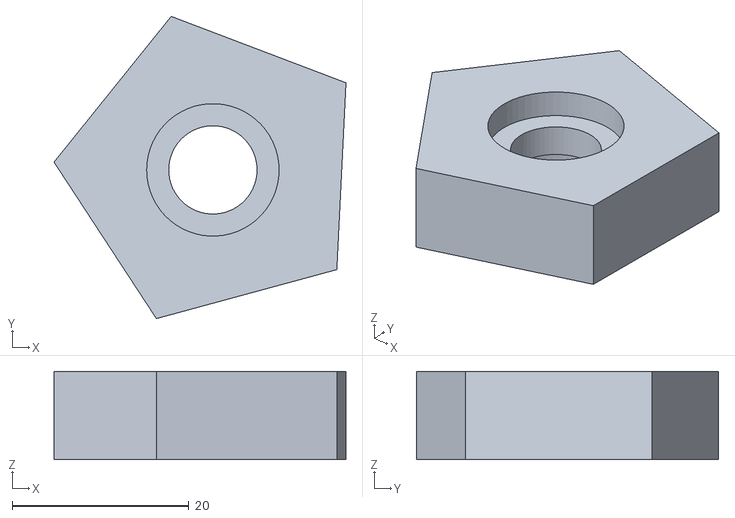
[picture p54: CAD file, 2023-03-06]
Pièces/Plaque_Principale/Foot_Main.stl
33.1 x 34.2 x 10.0
