JuliusOrtstadt/Maze_Game/Pièces/Mouvement/Main_Mouvement_Joint_Middle_V2.stl

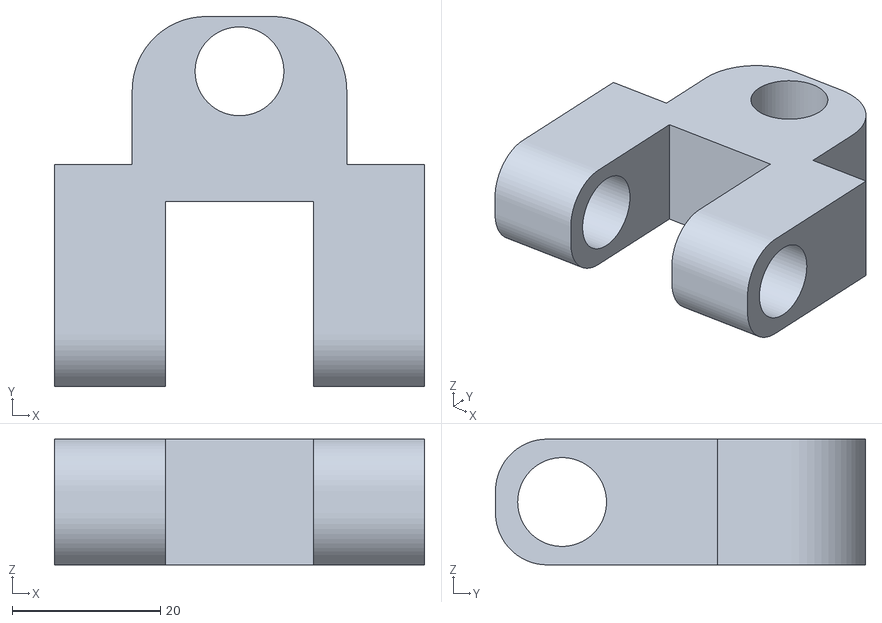
[picture p55: CAD file, 2023-03-06]
Pièces/Mouvement/Main_Mouvement_Joint_Middle_V2.stl
50.0 x 50.0 x 17.0
