JuliusOrtstadt/Maze_Game/Pièces/Mouvement/Fixation_Main_Servo.stl

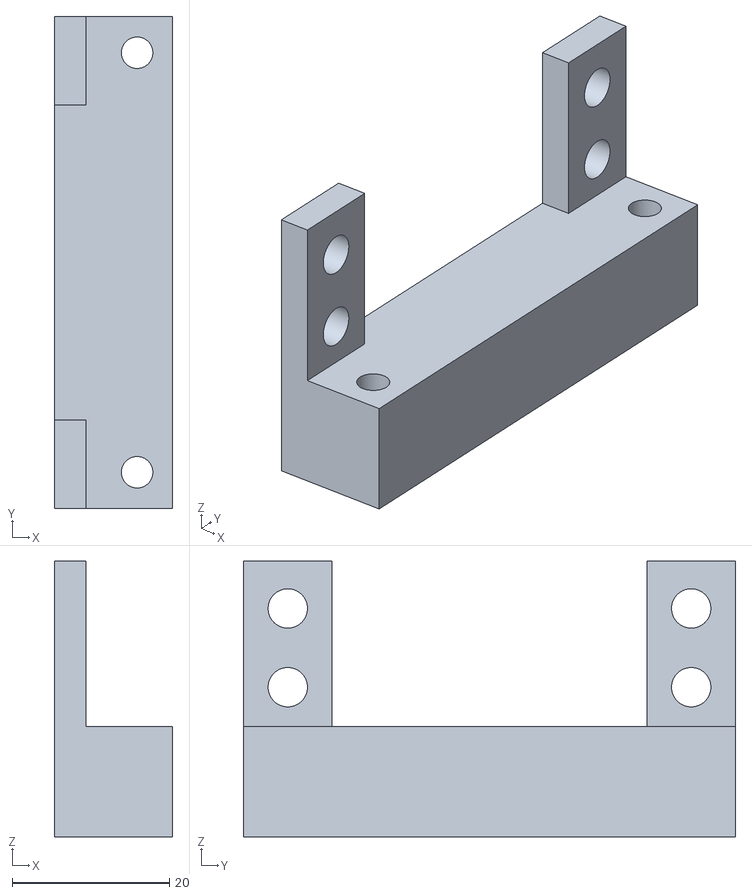
[picture p56: CAD file, 2023-03-06]
Pièces/Mouvement/Fixation_Main_Servo.stl
15.0 x 62.5 x 35.0
