JuliusOrtstadt/Maze_Game/Pièces/Mouvement/Main_Mouvement_Joint_Bottom.stl

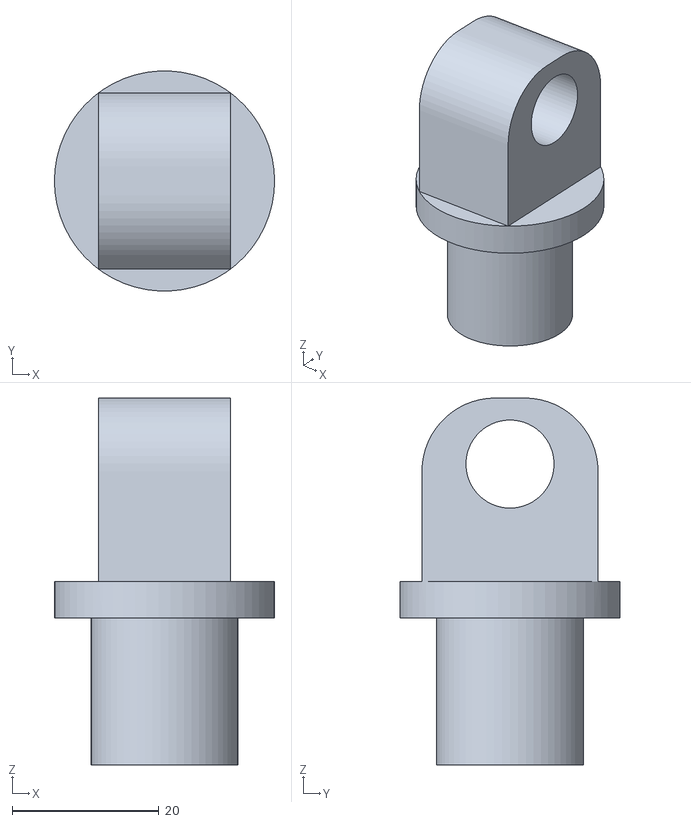
[picture p57: CAD file, 2023-03-06]
Pièces/Mouvement/Main_Mouvement_Joint_Bottom.stl
30.0 x 30.0 x 50.0
