JuliusOrtstadt/Maze_Game/Pièces/Mouvement/Angle.stl

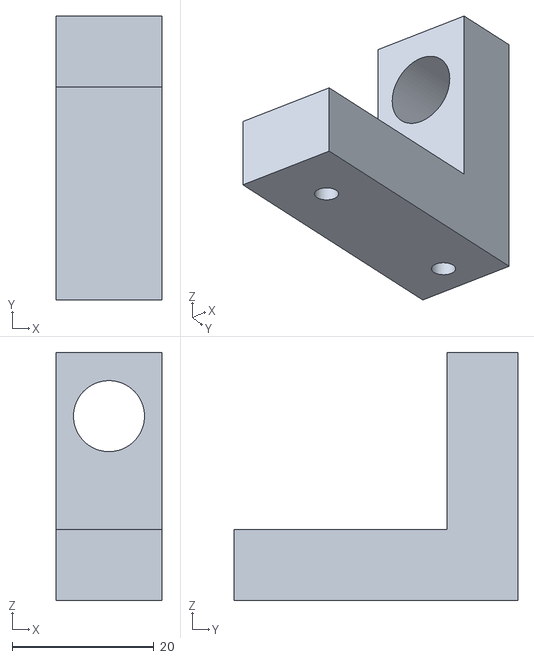
[picture p58: CAD file, 2023-03-06]
Pièces/Mouvement/Angle.stl
15.0 x 40.0 x 35.0
