JuliusOrtstadt/Maze_Game/Pièces/Porte/Door_Fixation.stl

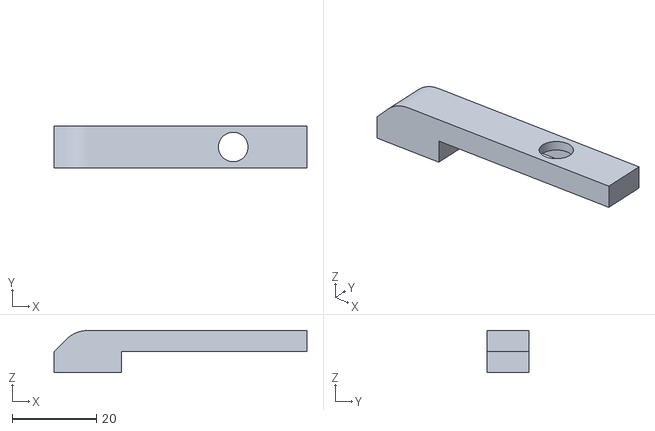
[picture p59: CAD file, 2023-03-06]
Pièces/Porte/Door_Fixation.stl
60.0 x 10.0 x 10.0
