JuliusOrtstadt/Maze_Game/Pièces/Récupération_Bille/Funel.stl

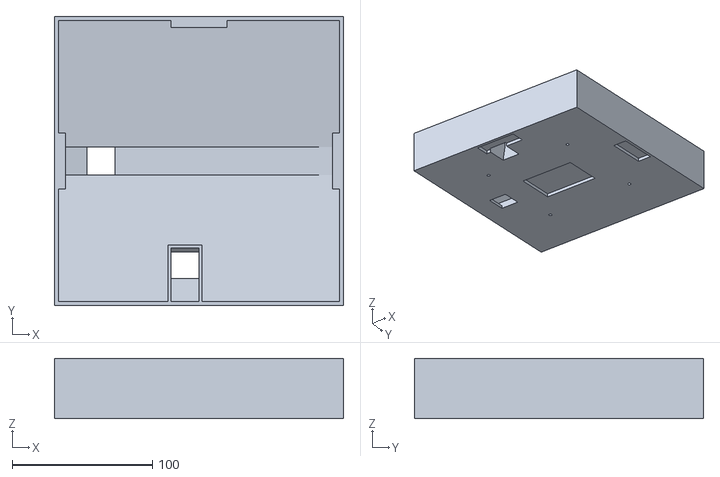
[picture p60: CAD file, 2023-08-08]
Pièces/Récupération_Bille/Funel.stl
206.0 x 206.0 x 43.0
