JuliusOrtstadt/Maze_Game/Pièces/Porte/Door_Servo_Hold.stl

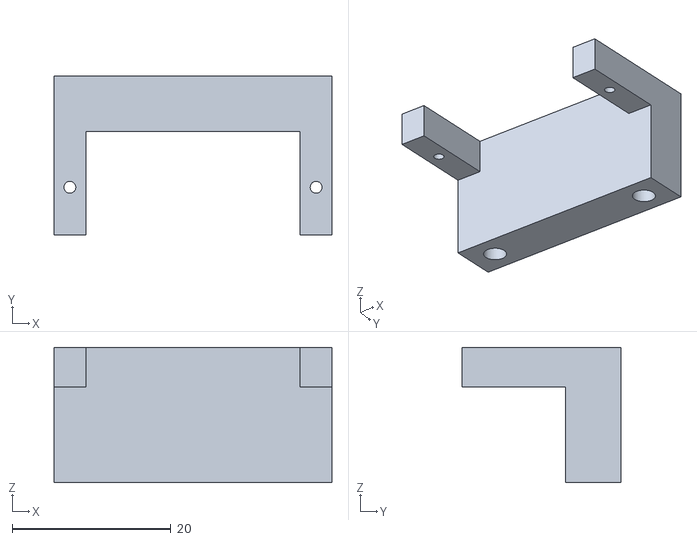
[picture p61: CAD file, 2023-03-06]
Pièces/Porte/Door_Servo_Hold.stl
35.0 x 20.0 x 17.0
