JuliusOrtstadt/Maze_Game/Pièces/Récupération_Bille/Collection_V3.stl

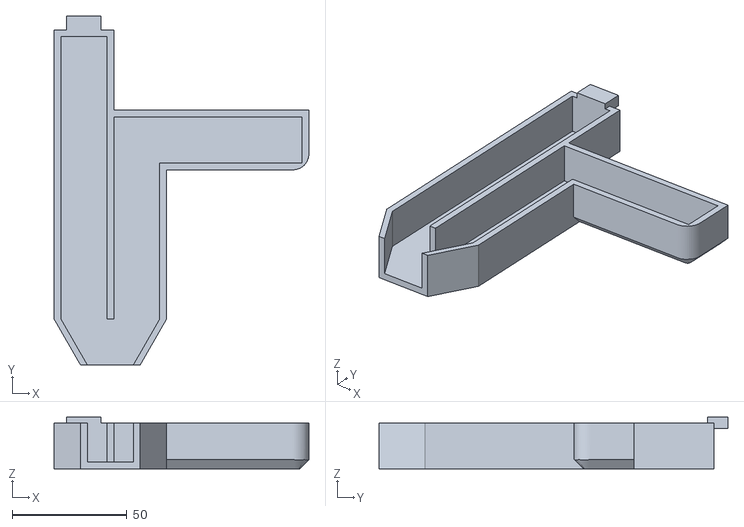
[picture p62: CAD file, 2023-03-06]
Pièces/Récupération_Bille/Collection_V3.stl
111.0 x 152.0 x 22.5
