JuliusOrtstadt/Maze_Game/Pièces/Mouvement/Rod.stl

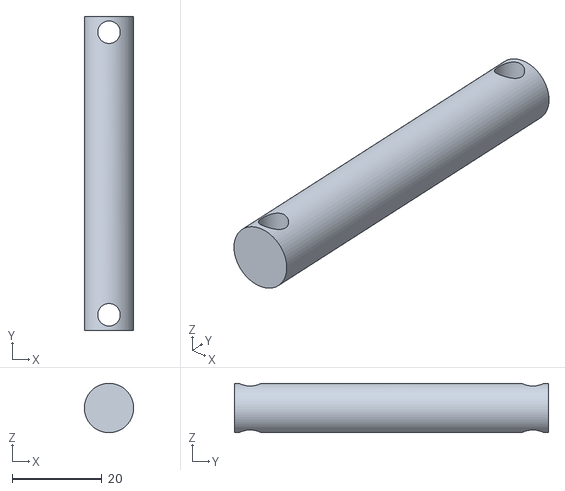
[picture p63: CAD file, 2023-03-06]
Pièces/Mouvement/Rod.stl
11.0 x 70.0 x 11.0
