JuliusOrtstadt/Maze_Game/Pièces/Mouvement/Mouvement_Joint_Part.stl

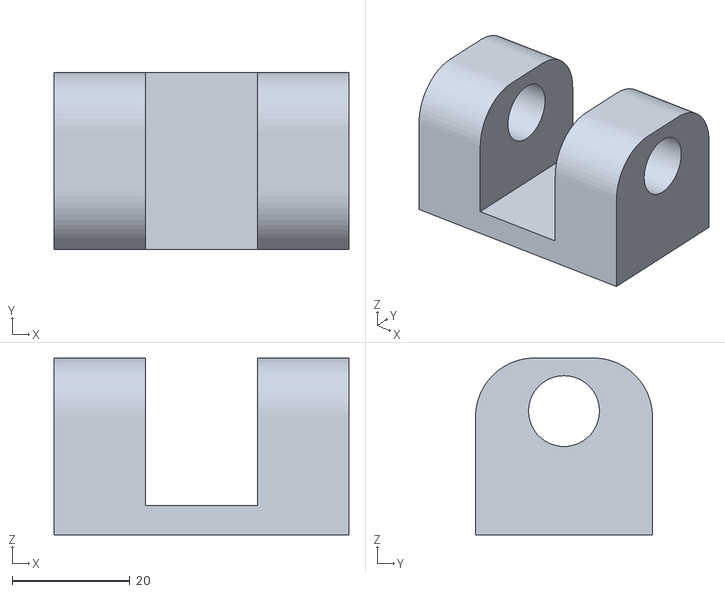
[picture p64: CAD file, 2023-03-06]
Pièces/Mouvement/Mouvement_Joint_Part.stl
50.0 x 30.0 x 30.0
