JuliusOrtstadt/Maze_Game/Pièces/Mouvement/Servo_Sleeve.stl

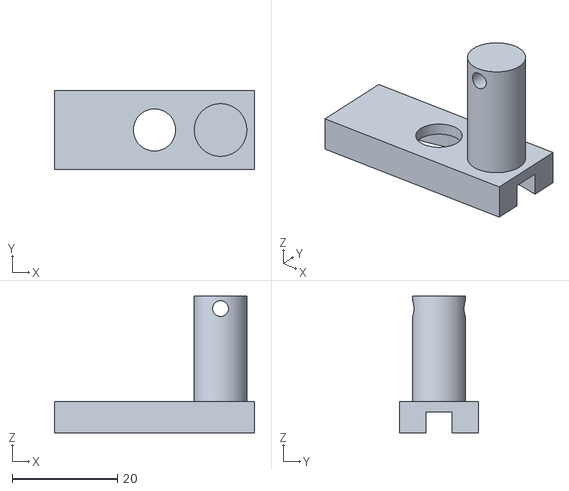
[picture p65: CAD file, 2023-03-06]
Pièces/Mouvement/Servo_Sleeve.stl
38.0 x 15.0 x 26.0
