JuliusOrtstadt/Maze_Game/Pièces/Mouvement/Mouvement_Translation_Rod.stl

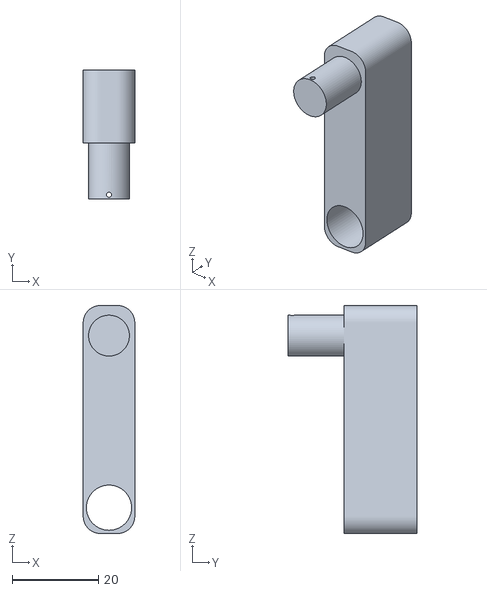
[picture p66: CAD file, 2023-03-06]
Pièces/Mouvement/Mouvement_Translation_Rod.stl
12.0 x 30.0 x 53.0
