JuliusOrtstadt/Maze_Game/(commit log)

2022-12-09 Create Cahier des charges.md
2022-12-09 Update Cahier des charges.md
2022-12-12 Rename Cahier des charges.md to Cahier_des_charges.md
